EmRosess/brazo-robotico-3gdl/(commit log)

2026-10-30 se traspaso constantes a el archivo config y la funcion inicializarsistema a el archivo driverservo
2026-11-05 version funcional de movimiento de 3 trayectorias a punto final, falta pila y deteccion
2026-11-05 se establecieron los parametros finales para apilamiento de los 3 cubos
2026-11-06 Arreglar estructura de carpetas y limpiar src
    [Controlador_comandos.h, Controlador_rutina.h, Driver_sensor.h, Driver_servos.h, Modelo_brazo.h, Modelo_cinematica.h, Vista_telemetria.h, config.h]
2026-11-06 Revise README for servo specs and installation steps
    Updated servo configuration and power supply details in README. Removed Python panel instructions and adjusted Android app setup steps.
2026-11-06 Update README.md
    Agregue información de la garra
2026-11-07 Revise D-H parameters and offset values
    Updated D-H parameters for robotic arm in README.
2026-11-07 Actualizacion de informe y se agrego un video del robot
2026-11-07 Actualizacion de comentarios en config.h
2026-11-09 Actualizacion de app movil se agrego grafico
